101010111100/openpnp-linear-rails/BOM.xlsx

Sheet: Machine
 | Quantity | Price | Extended | Source | Other Option | Notes
M5 x 30mm Low Profile Screw | 12 | $0.17 | $2.04 | http://openbuildspartstore.com/low-profile-screws-m5/ | https://www.fastenal.com/products/details/1139549 | Bed Mounting Bolts, 2 for each side of the the tensioning backet
M5 x 10mm Low Profile Screw | 28 | $0.13 | $3.64 | http://openbuildspartstore.com/low-profile-screws-m5/ | https://www.fastenal.com/products/details/MS2540012A20000 | 4 - for each Motor Brackets and Idler brackets to Extrusion (Tight, could probably be 10mm) 6 for each bracket to attach legs to cross pieces
M5 x 15mm Low Profile Screw | 20 | $0.13 | $2.60 | http://openbuildspartstore.com/low-profile-screws-m5/ | https://www.fastenal.com/products/details/1139539 | 4 - for each Sled Brackets to Extrusion (Tight, Could probably be 14mm) , 1 for each idler pulley
M5 T-Nuts | 94 | $0.08 | $7.52 | http://www.robotdigg.com/product/317 | http://openbuildspartstore.com/tee-nuts-25-pack/
M5 Washer | 12 | $0.02 | $0.24 | https://www.fastenal.com/products/details/1140354 | https://www.fastenal.com/products/details/1140354 | Used as spacers for the board
M3 x 8mm Socket Cap | 15 | $0.08 | $1.20 | http://openbuildspartstore.com/socket-head-screws-m3-25-pack/ | https://www.fastenal.com/products/details/MS2510008A40000 | (5 on each rail + Tnuts)
M3 x 10mm Socket Cap | 26 | $0.08 | $2.08 | http://openbuildspartstore.com/socket-head-screws-m3-25-pack/ | https://www.fastenal.com/products/details/MS2510010A40000 | (4 on each motor), (4 on each sled bracket)
M3 T-Nuts | 15 | $0.08 | $1.20 | http://www.robotdigg.com/product/317 |  | Attach rails to extrusion
M3 Washer | 12 | $0.03 | $0.36 | https://www.fastenal.com/products/details/MW6330000A20000 |  | Used for mounting the slide bracket to the slide
Extrusion Corner Mounts | 17 | $0.50 | $8.50 | http://www.ebay.com/itm/Four-4-2020-Corner-Bracket-Fittings-Industrial-Aluminum-/331513459607 | http://www.ebay.com/itm/331175021029
12mm Rail/Slide | 3 | $90.90 | $272.70 | http://www.ebay.com/itm/HIWIN-MGNR12-linear-guide-rail-600mm-23-6-with-MGN12H-blocks-3d-printer-CNC-kit-/262229961840 |  | Note, these are 600mm instead of the 500 specd, so extrusions may need to grow if you use these. Highly recommend the authentic THK at http://www.thkstore.com/products/linear-motion/linear-motion-guides/srs-m-set1.html (SRS12MUU+470LM)
Idler Pulley | 3 | $5.00 | $15.00 | COMING SOON | http://www.robotdigg.com/product/383 | If you decide to go with the 36T pulley, you will need 6 of the alternate part and 6 of the spacers
Idler Spacer | 3 | $0.12 | $0.36 | https://www.fastenal.com/products/details/0145769 | http://openbuildspartstore.com/aluminum-spacers/ | If you decide to go with the 36T pulley you will need 6 of these spacers
GT2 50T Pulley | 3 | $3.00 | $9.00 | http://www.robotdigg.com/product/551/2gt+pulley+50+teeth+5mm+bore | http://www.robotdigg.com/product/24/GT2+Pulley+36+Teeth+5mm+Bore | Originally we used 36T which worked well too
GT2 Timing Belt | 3 | $1.80 | $5.40 | http://www.robotdigg.com/product/10/Open+Ended+6mm+Width+GT2+Belt | http://openbuildspartstore.com/gt2-2mm-timing-belt/
24v Solenoid | 2 | $15.00 | $30.00 | http://www.robotdigg.com/product/566/High-frequency+Solenoid+Valve+24VDC
24v Power Supply | 1 | $32.00 | $32.00 | http://www.robotdigg.com/product/547/12+or+24v+350w+power+supply
Vacuum Source | 1 | $15.00 | $15.00 | http://www.robotdigg.com/product/599/Diaphragm+pump+4+desktop+PNP+Machine | http://www.ebay.com/itm/252168291599 | The better the vacuum you have the better
Vacuum Tubing | 20 | $1.14 | $22.80 | http://www.amazon.com/dp/B000FP0IV6/
Vacuum T | 3 | $0.16 | $0.48 | http://www.homedepot.com/p/DIG-1-4-in-Barb-Tees-10-Pack-H82A/100178513
Optical Endstops | 2 | $1.99 | $3.98 | http://www.ebay.com/itm/321760461548
SmoothieX5 Control Board | 1 | $149.99 | $149.99 | http://shop.uberclock.com/collections/smoothie/products/smoothieboard
USB Down Looking Camera | 1 | $37.99 | $37.99 | http://securityprotectionshop.com/products/full-hd-2mp-mini-cmos-ov2710-30fps60fps120fpsmjpegyuy2-1080p-usb-camera-android-for-atm-machines/ | http://www.aliexpress.com/item/Full-HD-H-264-720p-OV9712-Mjpeg-YUY2-uvc-micro-mini-cmos-usb-camera-module/32259206697.html | You want a 6mm lens, dont get the 3.6 or 2.1 as it is too fisheye
Nema17 Stepper Motors | 2 | $11.80 | $23.60 | http://openbuildspartstore.com/nema-17-stepper-motor/ | http://www.robotdigg.com/product/29/Nema17+60mm+high+torque+stepper+motor
Belt Tensioner Rods | 4 | $0.25 | $1.00 | https://www.fastenal.com/products/details/1126724 | http://openbuildspartstore.com/belt-clamp-crimp-style/
Head Unit | 1 | $300.00 | $300.00 | http://www.robotdigg.com/product/559/Headset+for+PNP+Machine
3/4" MDF Bed @ 425x460mm | 1 | $10.00 | $10.00 | Home Depot
1/8" Steel Top @ 425x460mm | 1 | $6.00 | $6.00 | Home Depot
Cable Chain | 2 | $12.95 | $25.90 | http://www.ebay.com/itm/380903707562
Juki Nozzles | 2 | $15.00 | $30.00 | http://www.robotdigg.com/product/467/NOZZLEs+for+SMT+Machine
Shaft extension (optional) | 1 | $4.19 | $4.19 | http://www.ebay.com/itm/391289162693 |  | Only needed if you decide to drive the passive rail
695ZZ Ball bearing (optional) | 1 | $0.50 | $0.50 | http://www.robotdigg.com/product/265/Ball+Bearing+693,+694,+695,+696,+698 |  | Only needed if you decide to drive the passive rail
Shaft coupler (optional) | 1 | $1.80 | $1.80 | http://www.robotdigg.com/product/354/Flexible+Clamping+Coupler+D20L25 |  | Only needed if you decide to drive the passive rail
Extrusions
20x40 Legs @ 150mm | 4 | $3.00 | $12.00 | http://www.ebay.com/itm/400466212791 | http://openbuildspartstore.com/v-slot-linear-rail/ | You can also order from misumi HFS5-2040-150
20x40 Rail Mounts @ 500mm | 3 | $8.00 | $24.00 | http://www.ebay.com/itm/400466212791 | http://openbuildspartstore.com/v-slot-linear-rail/ | You can also order from misumi HFS5-2040-500
20x40 HeadMount @ 53mm | 1 | $2.00 | $2.00 | http://www.ebay.com/itm/400466212791 | http://openbuildspartstore.com/v-slot-linear-rail/ | You can also order from misumi HFS5-2040-53
40x40 Cross Support @ 425mm | 2 | $12.00 | $24.00 | http://www.ebay.com/itm/330909339454 | http://openbuildspartstore.com/v-slot-40x40-linear-rail/ | You can also order from misumi HFS5-4040-425
20x20 Bed Support @ 380mm | 2 | $5.00 | $10.00 | http://www.ebay.com/itm/330909291089 | http://openbuildspartstore.com/v-slot-linear-rail/ | You can also order from misumi HFS5-2020-380
Milled / Printed Parts
Belt Tensioner Backet | 6 |  | $0.00 | http://a360.co/1SQV4dI | http://a360.co/1Qy8mbI | Source is the thin model (1/4" stock) Other Option is the 1/2" thicker stock. You only need 6 of these if you are going to drive the passive rail, otherwise you need 4
Rail Slide Mounting Bracket | 3 |  | $0.00 | http://a360.co/1RSZvEE | http://a360.co/1Qy8qIu | Source is the thin model (1/4" stock) Other Option is the 1/2" thicker stock
Motor Mount | 2 |  | $0.00 | http://a360.co/20HN1j8 | http://a360.co/1Qy8ub7 | "Source" is 50T, "other option" is for the 36T
Idler Pulley Mount | 7 |  | $0.00 | http://a360.co/24dva84 | http://a360.co/1OVz0uJ | "Source" is 50T, "other option" is for the 36T, you only need 7 of these if you are driving the passive rail otherwise you need 6
Passive Motor Mount (optional) | 1 |  | $0.00 | http://a360.co/1orMLbw |  | This is only necessary if you have sticky rails and/or want to drive the passive side
Top Head Mount | 1 |  | $0.00 | http://a360.co/1OVz1yJ
Bottom Head/Camera Mount | 1 |  | $0.00 | http://a360.co/1OVz39J
Endstop Mount | 2 |  | $0.00 | http://a360.co/1Qy8g3K
SmoothieX5 Mount | 1 |  | $0.00 | http://a360.co/1Qy8gB2
Vacuum System Mount | 1 |  | $0.00 | http://a360.co/1Qy8mZj
Nema8 Air Hose Adapter | 2 |  | $0.00 | http://a360.co/23dJGMF
 |  | Total Material | $1,099.07

Sheet: Test Board
Component | Quantity | Price | Extended | URL | Notes
PCB Test Parts
100 pin MCU (xms432p401ripzr) | 1 | $7.60 |  | https://store.ti.com/XMS432P401RIPZR.aspx
Atmega-328-au | 2 | $3.00
SOT-252 (V-Reg) | 1 | $0.79 |  | http://www.digikey.com/scripts/DkSearch/dksus.dll?Detail&itemSeq=188729858&uq=635895851622024562
QFN-32 (MCU) | 1 | $1.60 |  | http://www.digikey.com/product-detail/en/EFM32TG210F32-QFN32/914-1034-2-ND/2508076
TSSOP-20 | 1 | $0.59 |  | http://www.digikey.com/product-detail/en/74LVT245BBT20-13/74LVT245BBT20-13DICT-ND/5797428
SOP-16 | 1 | $0.49 |  | http://www.digikey.com/product-detail/en/74AHCT138T16-13/74AHCT138T16-13DICT-ND/4235054
Aluminum Cap | 2 | $0.87 |  | http://www.digikey.com/scripts/DkSearch/dksus.dll?Detail&itemSeq=188730532&uq=635895861729995258
5x5 Inductor | 2 | $0.50 |  | http://www.digikey.com/product-detail/en/TYS5040470M-10/240-2716-1-ND/4733625
npn | 12 | $0.20 |  | http://www.digikey.com/classic/Ordering/AddPart.aspx
SOT-223 | 1 | $0.59 |  | http://www.digikey.com/product-detail/en/DMN6068SE-13/DMN6068SE-13CT-ND/2295255
