101010111100/openpnp-linear-rails/models/FinalAssembly.stp

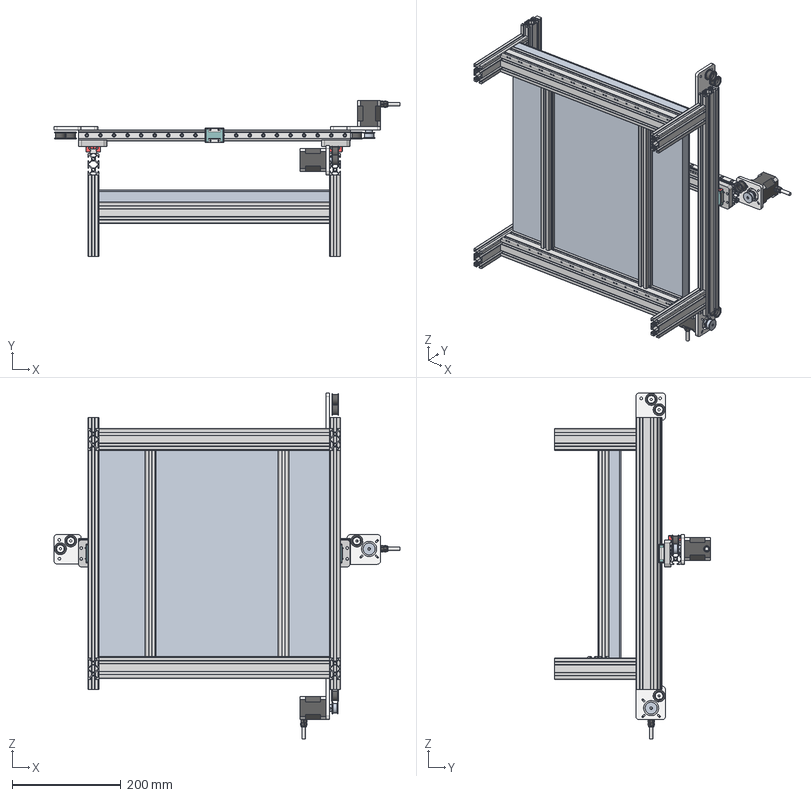
[picture p1: CAD file, 2016-03-13]
models/FinalAssembly.stp
637.0 x 287.5 x 637.0 mm
_20-2040-500-CL
SSR20XW1SS220200B(76
_Rail-MGN12R05001HM-10
_MGN12CZ0HM (1)
_EndSeal-MGN12 (1) x 2
_Bolt-MG12 (1) x 4
_MG-P-Screw-12-N (1)
_MG-Plug-Screw-12-N (1)
Leg x 4
Cross Piece x 2
_20-2040-500-CL_1 x 2
SSR20XW1SS220200B(76_1
V-Slot Motor Mount Plate.ipt.step.f3d v34 x 2
_MTR-DC17W-S-P5-P575 x 2
GT2 Timing Pulley v1 x 2
V-Slot Idler Pulley.ipt.f3d v1 x 6
V-Slot Motor Mount Plate.ipt.step.f3d v15 x 2
_Rail-MGN12R05001HM-10_1 x 2
_MGN12CZ0HM (1)_1 x 2
_EndSeal-MGN12 (1)_1 x 4
_Bolt-MG12 (1)_1 x 8
_MG-P-Screw-12-N (1)_1 x 2
_MG-Plug-Screw-12-N (1)_1 x 2
HWIN SINGLE x 2
Bed
_20-4040-425-CL x 2
SSR20XW1SS220200B(76_2
