101010111100/openpnp-linear-rails/models/Pulley Plate GT2.dxf

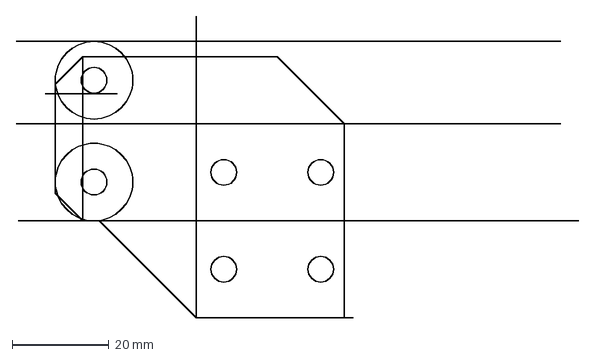
[picture p2: CAD file, 2016-06-17]
models/Pulley Plate GT2.dxf
116.0 x 62.2 mm
