101010111100/openpnp-linear-rails/models/Nema17 Motor Plate 20T GT2 Pulley.dxf

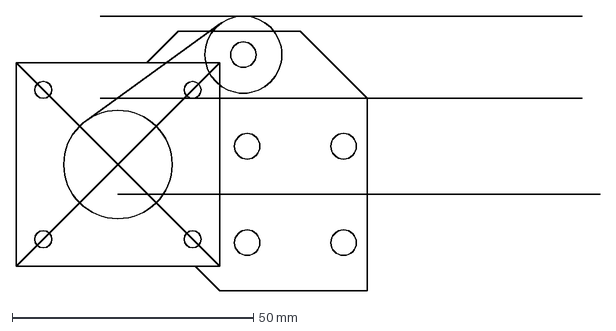
[picture p3: CAD file, 2016-06-17]
models/Nema17 Motor Plate 20T GT2 Pulley.dxf
121.2 x 57.0 mm
