101010111100/openpnp-linear-rails/models/X-Axis Motor Plate 20T GT2 Pulley.dxf

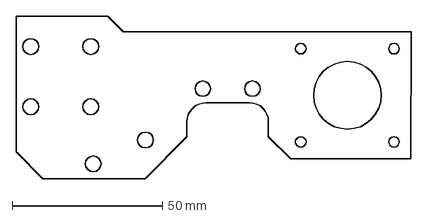
[picture p4: CAD file, 2016-06-17]
models/X-Axis Motor Plate 20T GT2 Pulley.dxf
131.3 x 53.9 mm
