101010111100/openpnp-linear-rails/models/2040 Extrusion.dxf

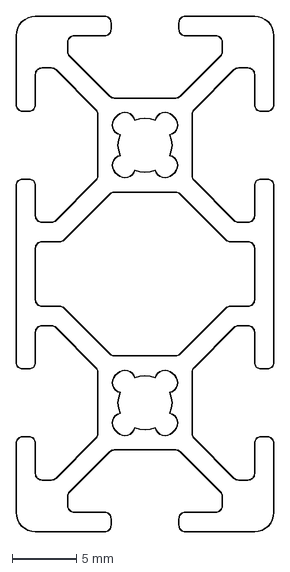
[picture p5: CAD file, 2016-06-17]
models/2040 Extrusion.dxf
20.0 x 40.0 mm
