101010111100/openpnp-linear-rails/models/2020 Extrusion.dxf

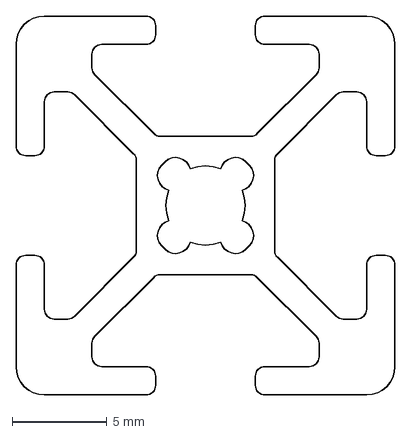
[picture p6: CAD file, 2016-06-17]
models/2020 Extrusion.dxf
20.0 x 20.0 mm
