101010111100/openpnp-linear-rails/models/4040 Extrusion.dxf

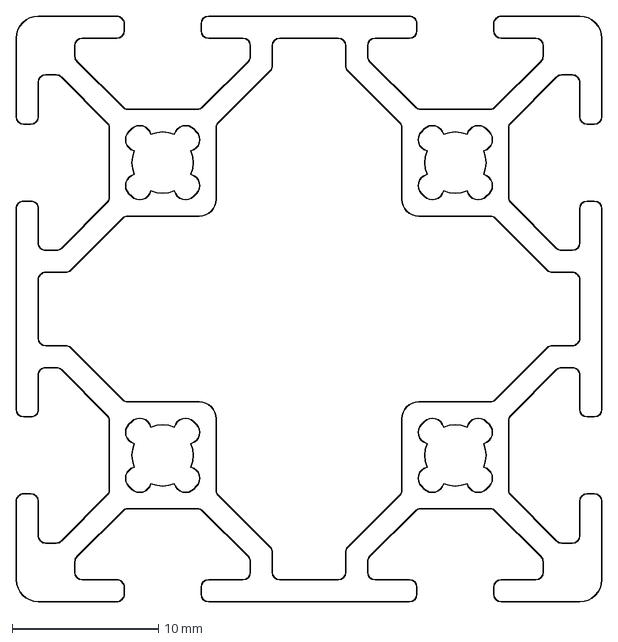
[picture p7: CAD file, 2016-06-17]
models/4040 Extrusion.dxf
40.0 x 40.0 mm
