101010111100/openpnp-linear-rails/models/Nema 17 Motor Mount Plate_Large Gear.stp

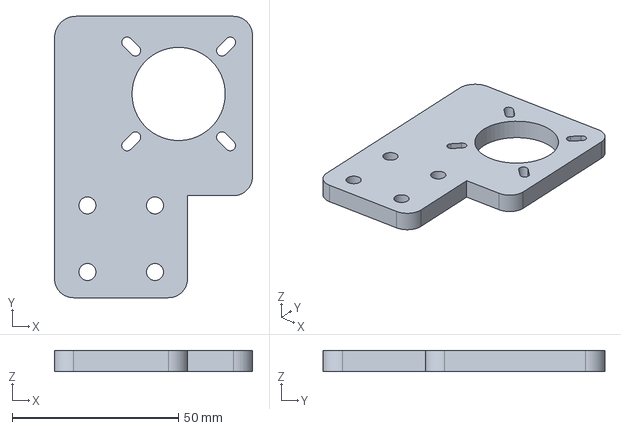
[picture p8: CAD file, 2016-03-13]
models/Nema 17 Motor Mount Plate_Large Gear.stp
59.5 x 84.6 x 6.35 mm
