101010111100/openpnp-linear-rails/models/Multi Sled Bracket.stp

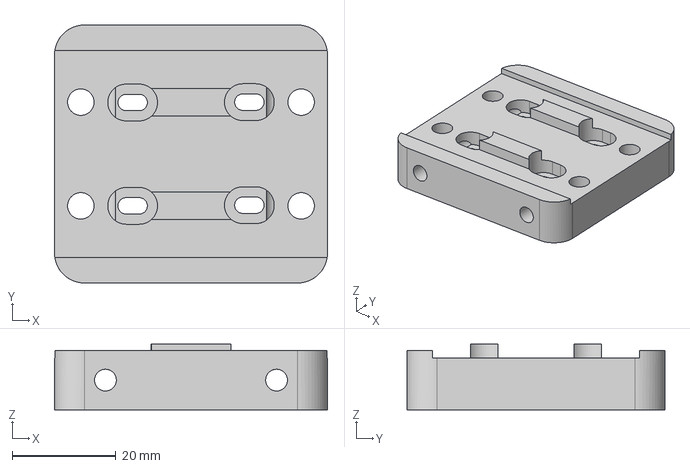
[picture p9: CAD file, 2016-03-13]
models/Multi Sled Bracket.stp
52.7 x 49.8 x 12.7 mm
