101010111100/openpnp-linear-rails/models/Endstop Bracket.stp

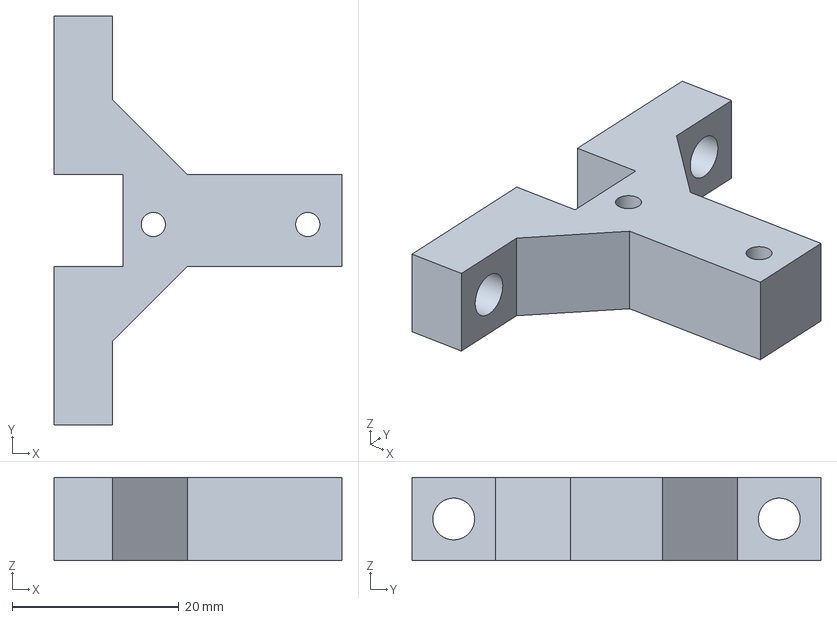
[picture p10: CAD file, 2016-03-13]
models/Endstop Bracket.stp
34.5 x 49.0 x 10.0 mm
