101010111100/openpnp-linear-rails/models/Belt Bracket (slim).stp

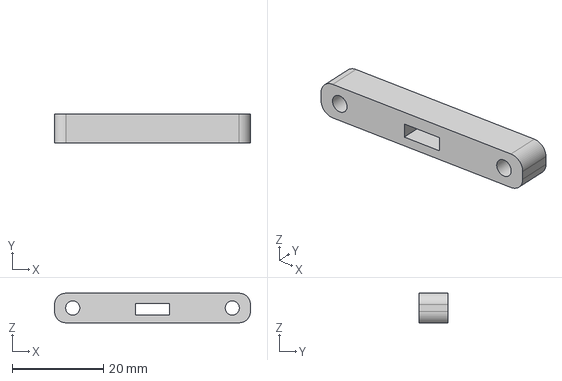
[picture p11: CAD file, 2016-03-13]
models/Belt Bracket (slim).stp
43.0 x 6.35 x 6.50 mm
