101010111100/openpnp-linear-rails/models/Multi Sled Bracket (slim).stp

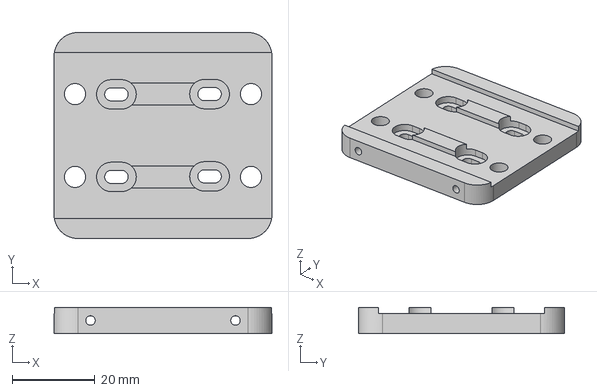
[picture p12: CAD file, 2016-03-13]
models/Multi Sled Bracket (slim).stp
52.7 x 49.8 x 6.35 mm
