101010111100/openpnp-linear-rails/models/Head Bracket Bottom (Camera).stp

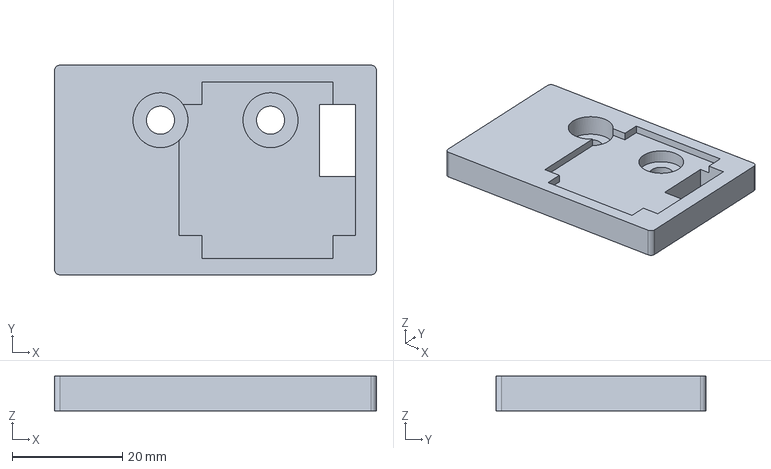
[picture p13: CAD file, 2016-03-13]
models/Head Bracket Bottom (Camera).stp
58.5 x 38.1 x 6.35 mm
