101010111100/openpnp-linear-rails/models/Smoothie Holder.stp

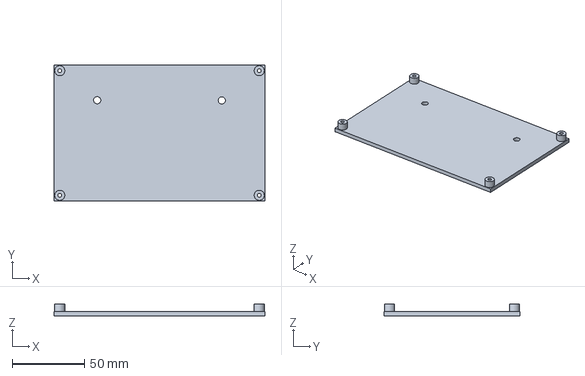
[picture p14: CAD file, 2016-03-13]
models/Smoothie Holder.stp
146.5 x 94.5 x 8.00 mm
