101010111100/openpnp-linear-rails/models/Head Bracket Top.stp

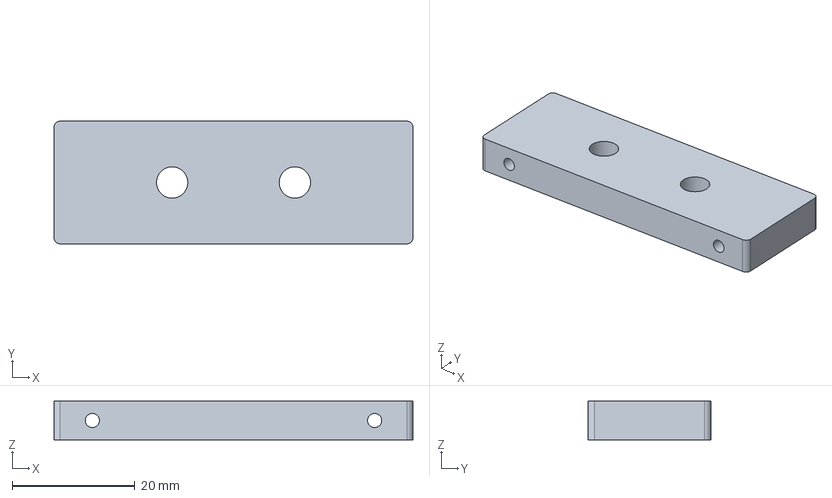
[picture p15: CAD file, 2016-03-13]
models/Head Bracket Top.stp
58.5 x 20.0 x 6.35 mm
