101010111100/openpnp-linear-rails/models/Idler Pulley Plate Large Idler.ipt.stp

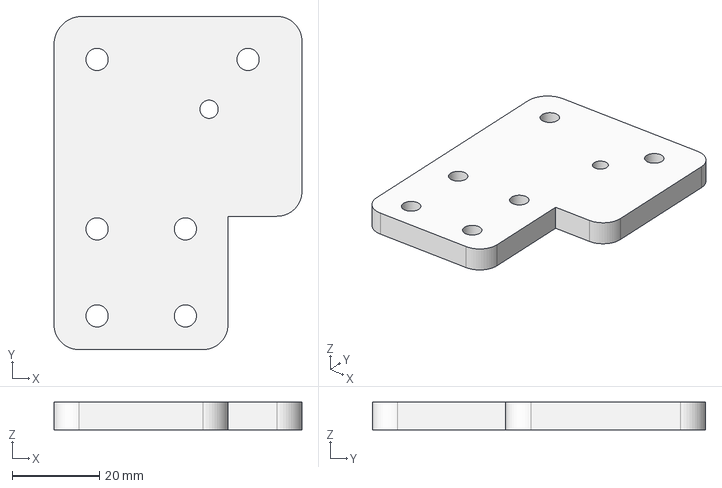
[picture p16: CAD file, 2016-03-13]
models/Idler Pulley Plate Large Idler.ipt.stp
57.0 x 76.6 x 6.35 mm
