101010111100/openpnp-linear-rails/models/Solenoid Housing.stp

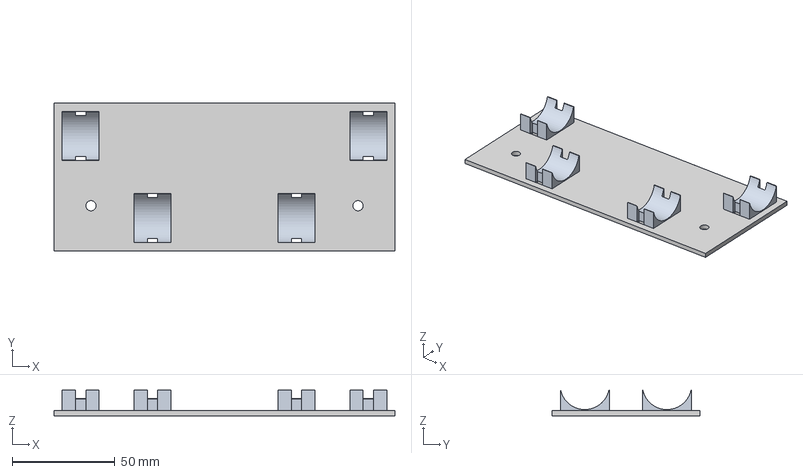
[picture p17: CAD file, 2016-03-13]
models/Solenoid Housing.stp
166.0 x 72.0 x 12.5 mm
mounting x 2
mounting (1)
mounting (2)
