101010111100/openpnp-linear-rails/models/Passive Rail Drive Bracket.stp

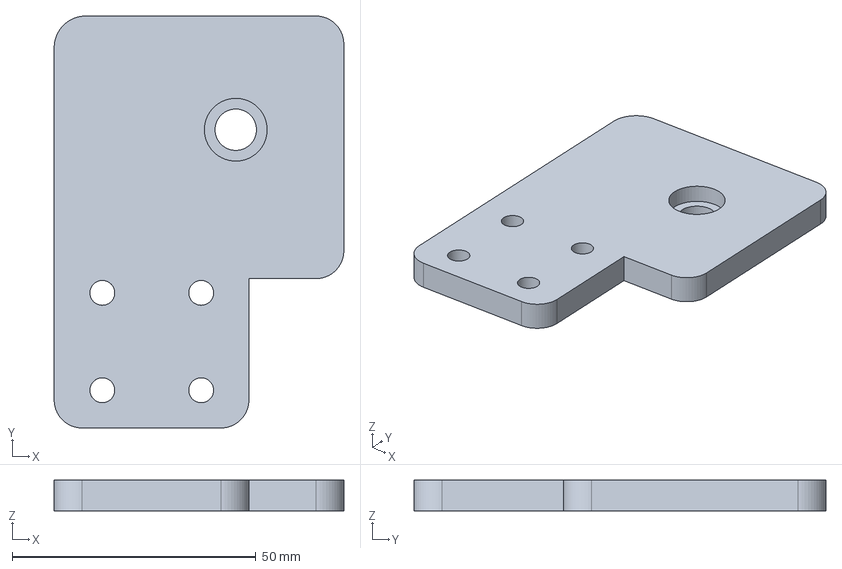
[picture p18: CAD file, 2016-03-13]
models/Passive Rail Drive Bracket.stp
59.5 x 84.6 x 6.35 mm
