101010111100/openpnp-linear-rails/models/Belt Bracket.stp

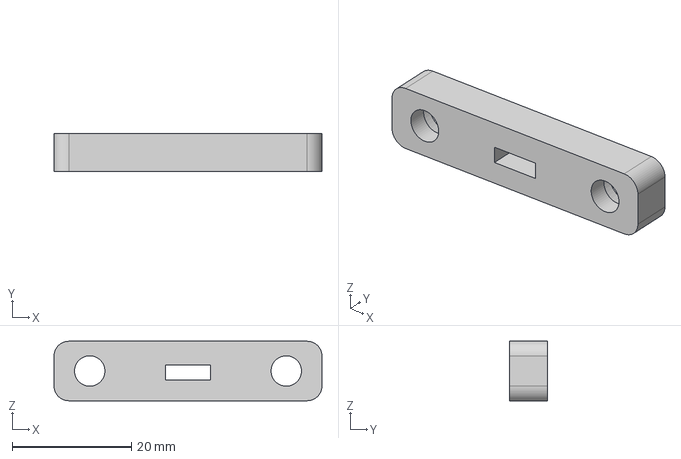
[picture p19: CAD file, 2016-03-13]
models/Belt Bracket.stp
45.0 x 6.35 x 10.0 mm
