101010111100/openpnp-linear-rails/models/Vacuum Gasket.stp

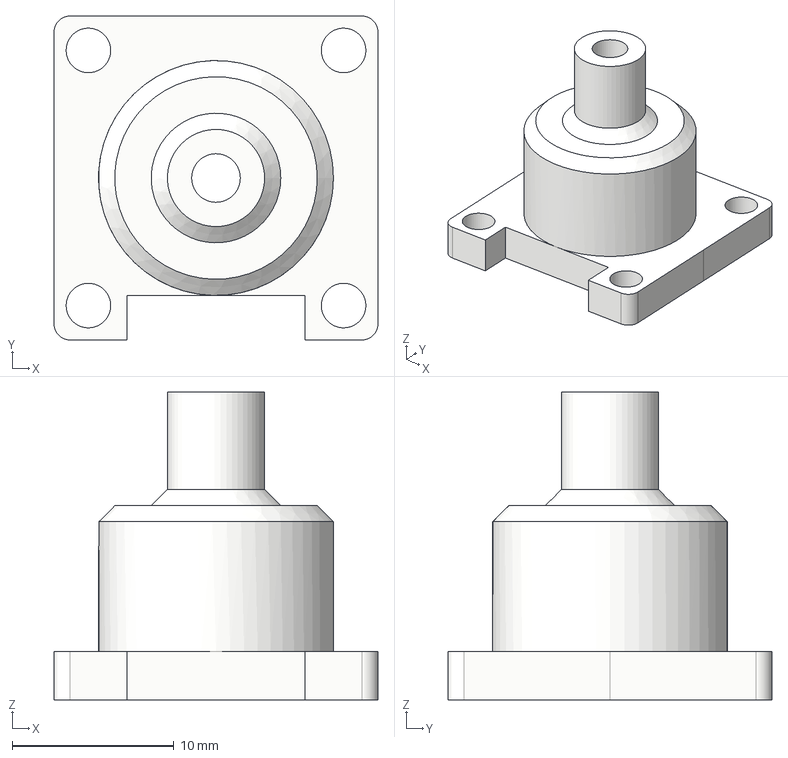
[picture p20: CAD file, 2016-03-13]
models/Vacuum Gasket.stp
20.0 x 20.0 x 19.0 mm
