101010111100/openpnp-linear-rails/(list of files, cad)

Other CAD files:
models/Belt Bracket (slim).f3d
models/Belt Bracket.f3d
models/Endstop Bracket.f3d
models/Head Bracket Bottom (Camera).f3d
models/Head Bracket Top.f3d
models/Idler Pulley Plate Large Idler.ipt.f3d
models/Multi Sled Bracket (slim).f3d
models/Multi Sled Bracket.f3d
models/Nema 17 Motor Mount Plate_Large Gear.f3d
models/Passive Rail Drive Bracket.f3d
models/Smoothie Holder.f3d
models/Solenoid Housing.f3d
models/Vacuum Gasket.f3d
