101010111100/openpnp-linear-rails/(commit log)

2016-03-13 Original BOM from Anthony Webb's DIY Pick and Place project (https://hackaday.io/project/9319-diy-pick-and-place): https://docs.google.com/spreadsheets/d/1ijdlkk7pOZnqEVCU9lDlx2OBI44QKNkokIkmXVnPd3g/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
    [BOM.xlsx]
2016-03-13 Original CAD models and assemblies from Anthony Webb's DIY Pick and Place project (https://hackaday.io/project/9319-diy-pick-and-place)
    [Belt Bracket (slim).f3d, Belt Bracket (slim).stp, Belt Bracket.f3d, Belt Bracket.stp, Endstop Bracket.f3d, Endstop Bracket.stp, FinalAssembly.stp, Head Bracket Bottom (Camera).f3d]
2016-03-27 Stock MKS SBase configuration and firmware
    [config.txt]
2016-03-27 Starting to customize configuration; values are guesses for now
    [config.txt]
2016-06-17 DXF files exported from Fusion 360
    [2020 Extrusion.dxf, 2040 Extrusion.dxf, 4040 Extrusion.dxf, Nema17 Motor Plate 20T GT2 Pulley.dxf, Pulley Plate GT2.dxf, X-Axis Motor Plate 20T GT2 Pulley.dxf]
